Bazilik00/Greenhouse-Public/README.md

# SmartGreenhouse
Проект умной теплицы на основе orange pi и esp32
