Bazilik00/Greenhouse-Public/documents/датчики.docx

Датчик влажности и температуры (х3)

AM2301 (Цифровой)

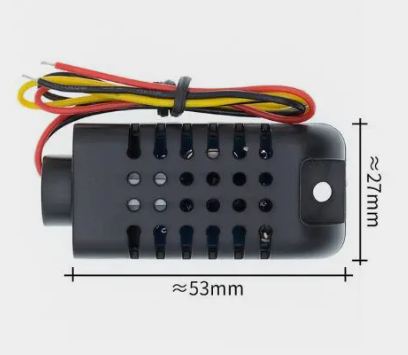
[picture p1: figure]

Datasheet:

https://www.haoyuelectronics.com/Attachment/AM2301/AM2301.pdf

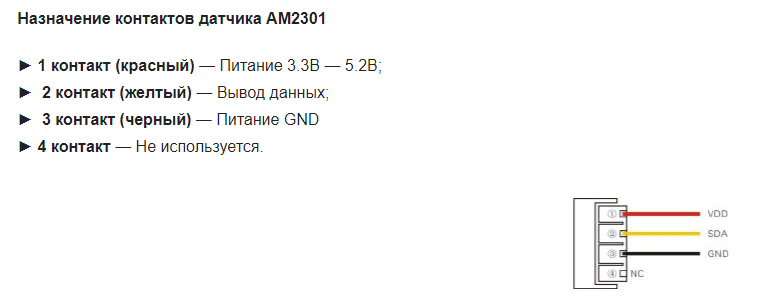
[picture p2: figure]
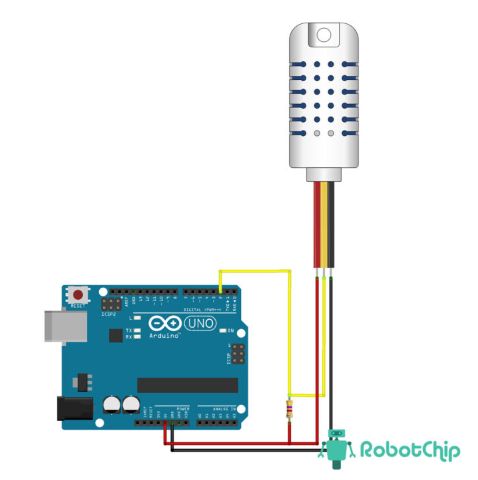
[picture p3: figure]

Датчик влажности почвы (х2)

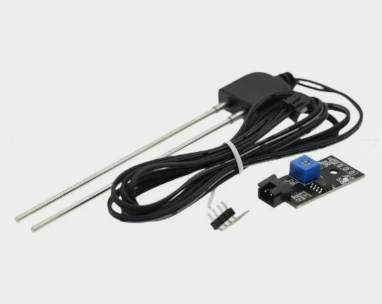
[picture p4: figure]

https://aliexpress.ru/item/1005001602176570.html?sku_id=12000027556991239

Датчик уровня воды

Вариант 1

Бесконтактный датчик уровня жидкости XKC-Y25-V (Цифровой)

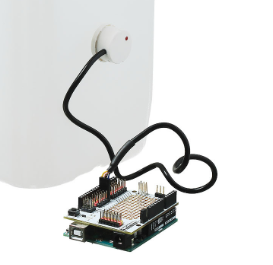
[picture p5: figure]
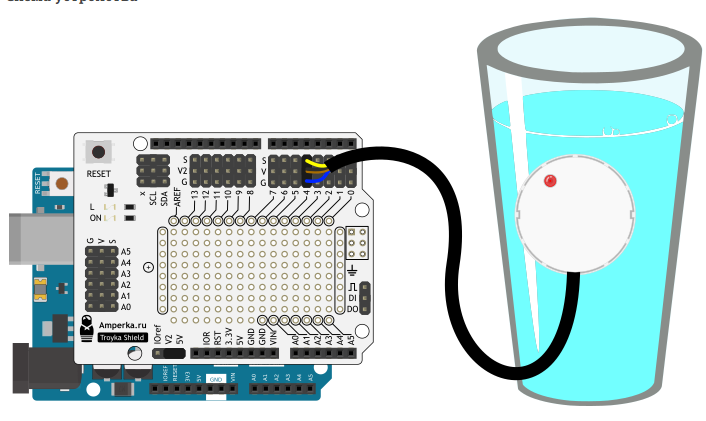
[picture p6: figure]

https://aliexpress.ru/item/1005004159360740.html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

Datasheet:

https://naylampmechatronics.com/img/cms/Datasheets/XKC%20Y25%20T12V.pdf

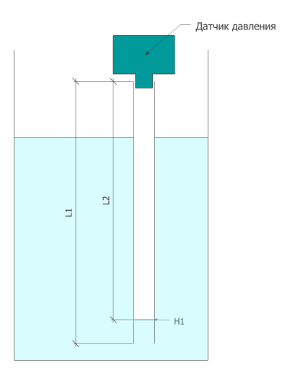
[picture p7: figure]

Фитолампа

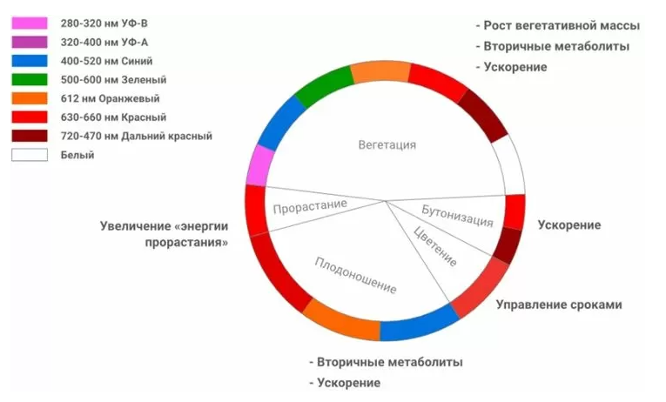
[picture p8: figure]
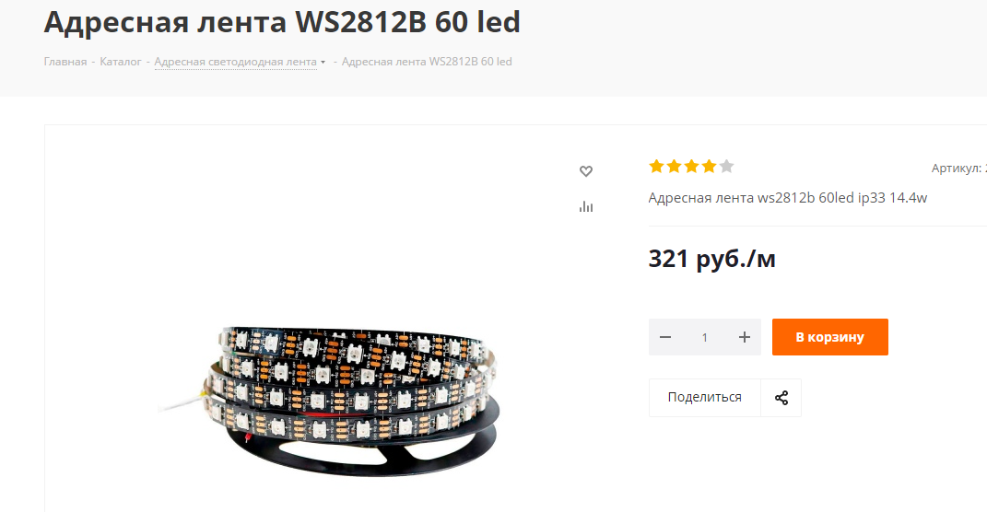
[picture p9: figure]
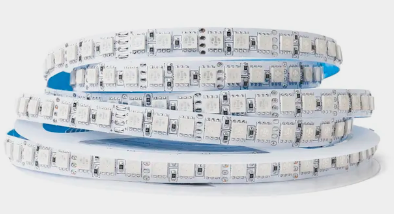
[picture p10: figure]

https://aliexpress.ru/item/32823192884.html?sku_id=12000022273737416

Дисплей

https://aliexpress.ru/item/1005004405216318.html?sku_id=12000029064772982&spm=.search_results.1.47d64aa6dzM306

https://aliexpress.ru/item/1005002863549499.html?sku_id=12000028120668882&spm=.search_results.2.47d64aa6dzM306

Датчик освещённости (х3)

GL5528

https://aliexpress.ru/item/32623615207.html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

https://aliexpress.ru/item/32760631393.html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

Увлажнитель

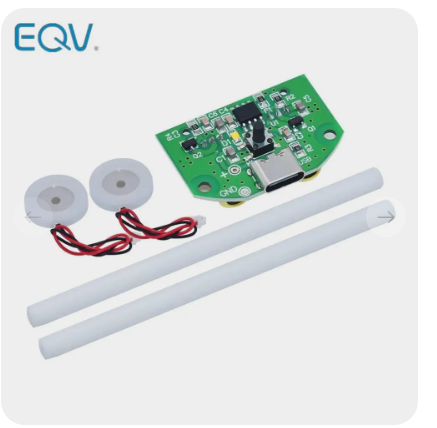
[picture p11: figure]

https://aliexpress.ru/item/1005004635978472.html?sku_id=12000029922315880&spm=.search_results.2.6d873387IbZYXX

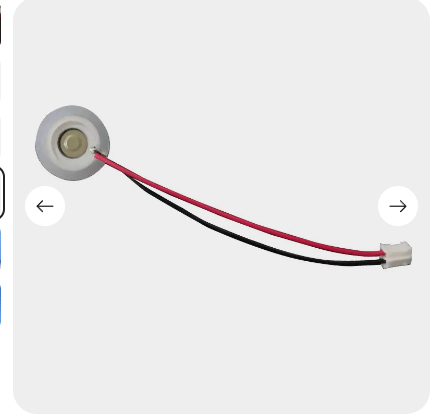
[picture p12: figure]

https://aliexpress.ru/item/1005003789313581.html?sku_id=12000027173766967&spm=.search_results.5.6d873387IbZYXX

Опторапара

Датчик препятствия (оптопара) QT30CM

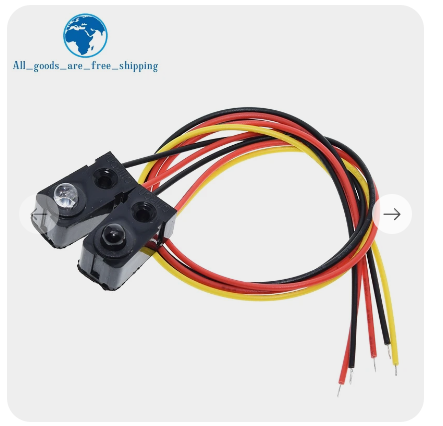
[picture p13: figure]

https://aliexpress.ru/item/4000426799677.html?sku_id=12000037068859744
