Bazilik00/Greenhouse-Public/3d model/платформа под бак.stl

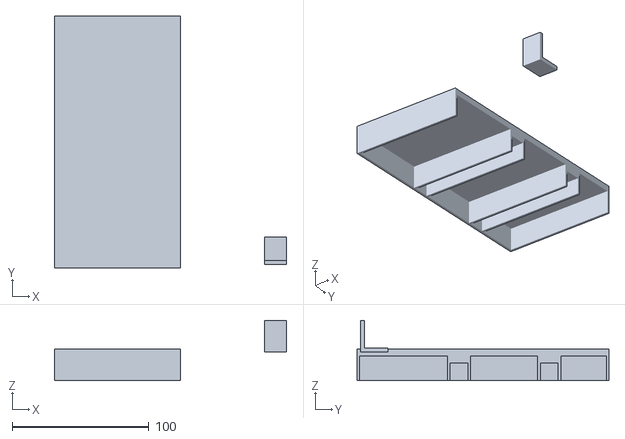
[picture p44: CAD file, 2024-06-30]
3d model/платформа под бак.stl
169.5 x 184.0 x 44.0
