Bazilik00/Greenhouse-Public/3d model/Магниты на дверцы(2).stl

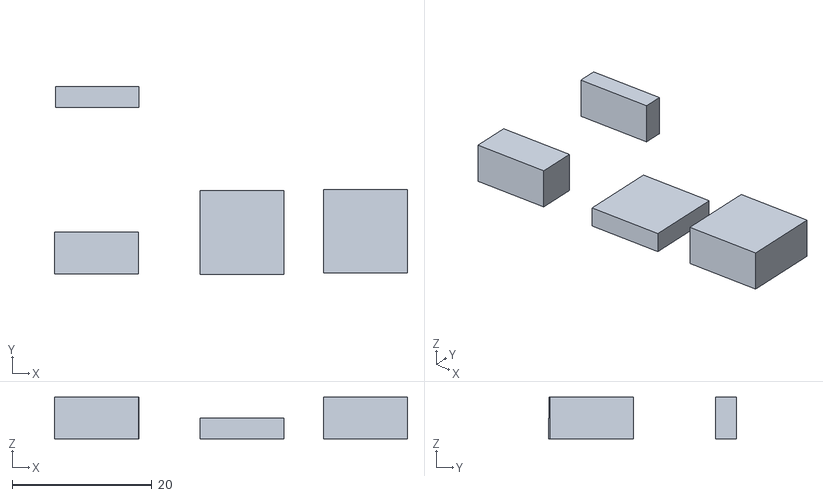
[picture p45: CAD file, 2024-06-30]
3d model/Магниты на дверцы(2).stl
50.6 x 26.9 x 6.00
