Bazilik00/Greenhouse-Public/3d model/петля(5).stl

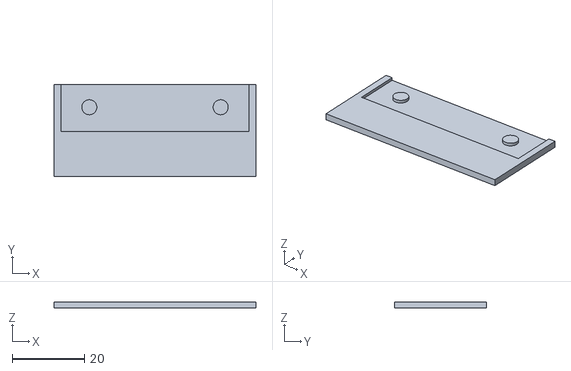
[picture p46: CAD file, 2024-06-30]
3d model/петля(5).stl
56.0 x 25.5 x 1.80
