Bazilik00/Greenhouse-Public/3d model/петля(4).stl

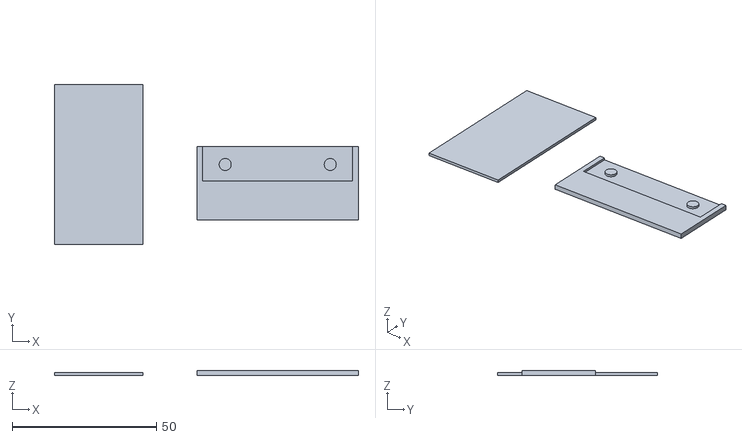
[picture p47: CAD file, 2024-06-30]
3d model/петля(4).stl
105.4 x 55.6 x 1.80
