Bazilik00/Greenhouse-Public/(list of files, cad)

Other CAD files:
3d model/Кронштейны под эл.платы.skp
