Bazilik00/Greenhouse-Public/source/MCU/src/pins.h

#define PIN_AM2301 13
#define PIN_SOIL 35
#define PIN_LIGHT 34
#define PIN_RGB 32
#define PIN_SERVO 33
#define PIN_FAN 16
#define PIN_PUMP 21
#define PIN_HUMIDIFIER 17
#define PIN_AM2301_OUTSIDE 2
#define PIN_LIGHT_OUTSIDE 36
#define PIN_LEVEL_WATER 4
 

#define NUM_RGB_LEDS 68
