Bazilik00/Greenhouse-Public/source/Snippets/Soil moisture sensor/src/Light sensor maybe.cpp

// #include <Arduino.h>

// int sensor = 39;
// int Free = 0; 

// void setup() {
//   Serial.begin(115200);                       
//   pinMode(sensor, INPUT);                       
// }

// void loop() {
//   Free = analogRead(sensor);                
//   Serial.println(Free); 
//   delay(100);                           
// }  
