Bazilik00/Greenhouse-Public/source/Snippets/Soil moisture sensor/src/level water.cpp

// #include <Arduino.h>

// int sensor_pin = 33;
// int data;

// void setup() {
//  Serial.begin(115200);
//  pinMode(sensor_pin, INPUT);                      
// }

// void loop() {
//   // считываем состояние пина
//   int motionState = digitalRead(sensor_pin);
//   Serial.println(motionState);
//   delay(100);                           
// }
