Bazilik00/Greenhouse-Public/source/Snippets/Soil moisture sensor/src/servo.cpp

// #include <Arduino.h>
// #include <ESP32Servo.h>

// Servo servo;  // Создаем объект


// void setup() {
//   Serial.begin(115200);
//   servo.attach(33);   // Указываем объекту класса Servo, что серво присоединен к пину 9
//   servo.write(0);                      
// }

// void loop() {
//    if (Serial.available()) 
//    {  
//       servo.write(Serial.parseInt()); 
//    };
//    delay(100);
                         
// }
